SP8EBC/ParaCNTRL/README.md

# ParaCNTRL
FM repeater controller build w/o using any microntroller, Arduino or even Raspberry PI ;) Only op-amps and 74HCxx inside ;)
