SP8EBC/ParaCNTRL/_output_files/hw-rev-a/micros_com_pl.odt

## Your order

Item | | Name | Quantity | Net price | Net value
1 | (https://www.micros.com.pl/gfx/micros/_thumbsms/mediaserver/ac/65/82/ac6582d0db987ab54aea2be8b7d9221c,mFPcf2SPaw.jpg) (https://www.micros.com.pl/gfx/micros/_thumbsms/mediaserver/ac/65/82/ac6582d0db987ab54aea2be8b7d9221c,mFPcf2SPaw.jpg) | 74LVC1G06GW,125 Nexperia (https://www.micros.com.pl/en/product/ut006lvc1g-gw,126243.html)Micros part number: UT006lvc1g gw Manufacturer: NXP Manufacturer part number: 74LVC1G06GW RoHS Case style: SC70-5 t/r 5 0,8100 PLN 4,05 PLN Total:: 5 4,05 PLN
2 | (https://www.micros.com.pl/gfx/micros/_thumbsms/mediaserver/cb/0e/c9/cb0ec908718b7982ce16db11b44bc81b,mFPcf2SPaw.jpg) (https://www.micros.com.pl/gfx/micros/_thumbsms/mediaserver/cb/0e/c9/cb0ec908718b7982ce16db11b44bc81b,mFPcf2SPaw.jpg) | 74LVC1G06 SOT23-5 (https://www.micros.com.pl/en/product/ut006lvc1g-dbv,51417.html)Micros part number: UT006lvc1g dbv Manufacturer: Texas Instruments Manufacturer part number: SN74LVC1G06DBVR RoHS Case style: SOT23-5/t/r 5 1,0500 PLN 5,25 PLN Total:: 5 5,25 PLN
3 | (https://www.micros.com.pl/gfx/micros/_thumbsms/mediaserver/19/ed/58/19ed5894784a9232bdaf99e90b2cf70d,mFPcf2SPaw.jpg) (https://www.micros.com.pl/gfx/micros/_thumbsms/mediaserver/19/ed/58/19ed5894784a9232bdaf99e90b2cf70d,mFPcf2SPaw.jpg) | TAJB106K020RNJ AVX/ 293D106X9020B2TE3 VISHAY Capacitor (https://www.micros.com.pl/en/product/ktsb-10-0020k,17437.html)Micros part number: KTSB 10.00/20k Manufacturer: AVX Manufacturer part number: TAJB106K020RNJ RoHS Case style: smdB 3 1,6300 PLN 4,89 PLN Total:: 3 4,89 PLN
4 | (https://www.micros.com.pl/gfx/micros/_thumbsms/mediaserver/19/ed/58/19ed5894784a9232bdaf99e90b2cf70d,mFPcf2SPaw.jpg) (https://www.micros.com.pl/gfx/micros/_thumbsms/mediaserver/19/ed/58/19ed5894784a9232bdaf99e90b2cf70d,mFPcf2SPaw.jpg) | TAJB226K020RNJ AVX/ 293D226X9020B2TE3 VISHAY Capacitor (https://www.micros.com.pl/en/product/ktsb-22-0020k,67834.html)Micros part number: KTSB 22.00/20k Manufacturer: AVX Manufacturer part number: TAJB226K020RNJ RoHS Case style: smdB 6 1,3200 PLN 7,92 PLN Total:: 6 7,92 PLN

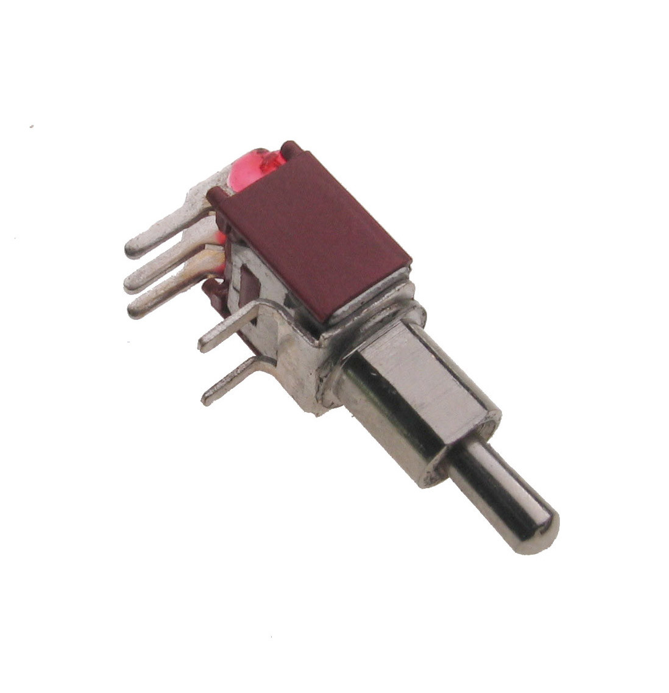
[picture p1: figure]
PRZ Smts103-2c3

5 | (https://www.micros.com.pl/gfx/micros/_thumbsms/mediaserver/ca/92/e7/ca92e7755cf07c80c8746512d54e2226,mFPcf2SPaw.jpg) (https://www.micros.com.pl/gfx/micros/_thumbsms/mediaserver/ca/92/e7/ca92e7755cf07c80c8746512d54e2226,mFPcf2SPaw.jpg) | SMTS103-2C3; toggle switch; (https://www.micros.com.pl/en/product/prz-smts103-2c3,19807.html)Micros part number: PRZ Smts103-2c3 Manufacturer: SWI Manufacturer part number: SMTS103-2C3 RoHS Case style: Rys.SMTS103-2C3 3 3,4300 PLN 10,29 PLN Total:: 3 10,29 PLN
6 | (https://www.micros.com.pl/gfx/micros/_thumbsms/mediaserver/99/41/b0/9941b08c1a6434a5edda34bfec541344,mFPcf2SPaw.jpg) (https://www.micros.com.pl/gfx/micros/_thumbsms/mediaserver/99/41/b0/9941b08c1a6434a5edda34bfec541344,mFPcf2SPaw.jpg) | SMTS202-2C3; toggle switch; (https://www.micros.com.pl/en/product/prz-smts202-2c3,19808.html)Micros part number: PRZ Smts202-2c3 Manufacturer: SWI Manufacturer part number: SMTS202-2C3 RoHS Case style: Rys.SMTS202-2C3 2 3,9300 PLN 7,86 PLN Total:: 2 7,86 PLN
7 | (https://www.micros.com.pl/gfx/micros/_thumbsms/mediaserver/3e/b4/0f/3eb40f9707c2ff876c856c0472e9234c,mFPcf2SPaw.jpg) (https://www.micros.com.pl/gfx/micros/_thumbsms/mediaserver/3e/b4/0f/3eb40f9707c2ff876c856c0472e9234c,mFPcf2SPaw.jpg) | SOP04E SAB dip-switch IC type, 4 contacts, SMD montage p. 1.27mm (https://www.micros.com.pl/en/product/prz-dipicns04,37205.html)Micros part number: PRZ DipICns04 Manufacturer: SAB Manufacturer part number: SOP04E RoHS Case style: Rys.dswICns4 1 5,6600 PLN 5,66 PLN Total:: 1 5,66 PLN
8 | (https://www.micros.com.pl/gfx/micros/_thumbsms/mediaserver/94/1f/1e/941f1e0265697d530bcd1b340b5c7ba9,mFPcf2SPaw.jpg) (https://www.micros.com.pl/gfx/micros/_thumbsms/mediaserver/94/1f/1e/941f1e0265697d530bcd1b340b5c7ba9,mFPcf2SPaw.jpg) | Single turn shaft potentiometer; 10K (https://www.micros.com.pl/en/product/po-r16148-1a-2-a10k,114040.html)Micros part number: PO R16148-1A-2-A10K Manufacturer: BOCHEN Manufacturer part number: WH148-1A-2-A 10kR RoHS Case style: Rys.R16148-1A-2 5 1,5400 PLN 7,70 PLN Total:: 5 7,70 PLN

Net products | Net delivery cost | Net amount | VAT 23 % | Total cost
53,62 PLN | 24,02 PLN | 77,64 PLN | 17,86 PLN | 95,50 PLN
