SP8EBC/ParaCNTRL/_output_files/Screenshot 2023-04-19 at 16-11-43 Order _ Micros.png

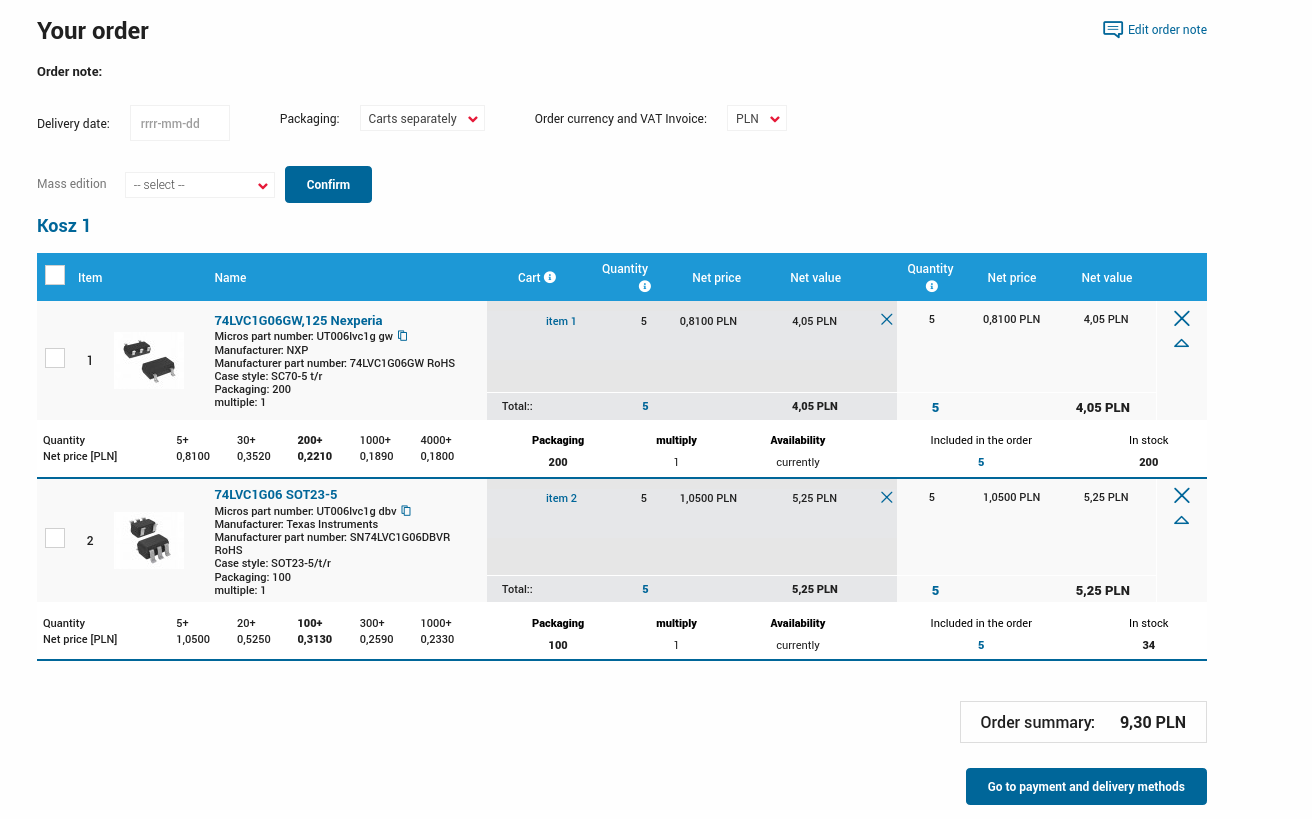
_output_files/Screenshot 2023-04-19 at 16-11-43 Order _ Micros.png
