SP8EBC/ParaCNTRL/74HC244D_652/74HC244D_652.step

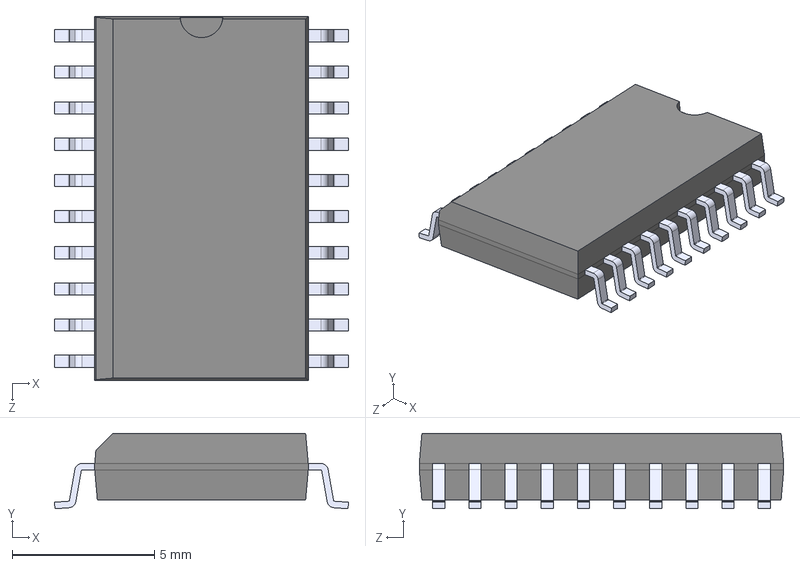
[picture p3: CAD file, 2023-02-25]
74HC244D_652/74HC244D_652.step
10.3 x 2.65 x 12.8 mm
