SP8EBC/ParaCNTRL/NFE31PT222Z1E9L/NFE31PT222Z1E9L.step

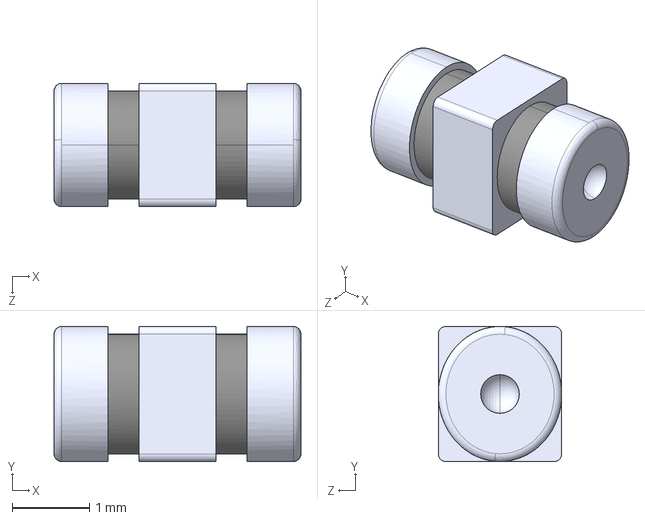
[picture p4: CAD file, 2023-02-25]
NFE31PT222Z1E9L/NFE31PT222Z1E9L.step
3.20 x 1.75 x 1.60 mm
