SP8EBC/ParaCNTRL/PLT10HH1026R0PNL/PLT10HH1026R0PNL.step

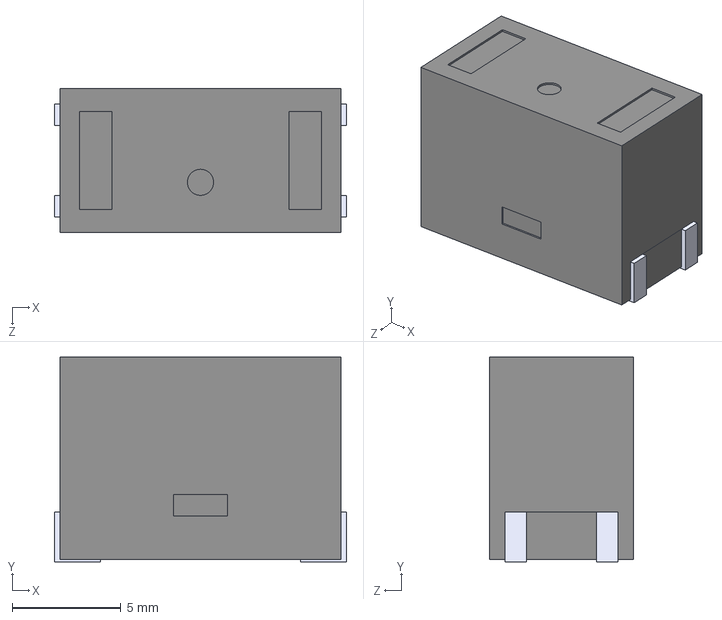
[picture p5: CAD file, 2023-02-25]
PLT10HH1026R0PNL/PLT10HH1026R0PNL.step
13.4 x 9.40 x 6.60 mm
