SP8EBC/ParaCNTRL/(threads)

Thread 1 (2023-06-17):

Problems with hardware revision B

SP8EBC, 2023-06-17:
1. IC702 doesn't have supply voltage and ground connected
2. Unconnected ground plane around C503, influences U20
3. Missing buffering of ROGER_PTT_CNTRL_OUT signal. Workarounded by reducing R208
4. Some potentiometers are flipped that decreasing signal goes clockwise, which is weird and uncommon.
