SP8EBC/ParaCNTRL/_output_files/hw-rev-b/fm-rpt-control.pdf

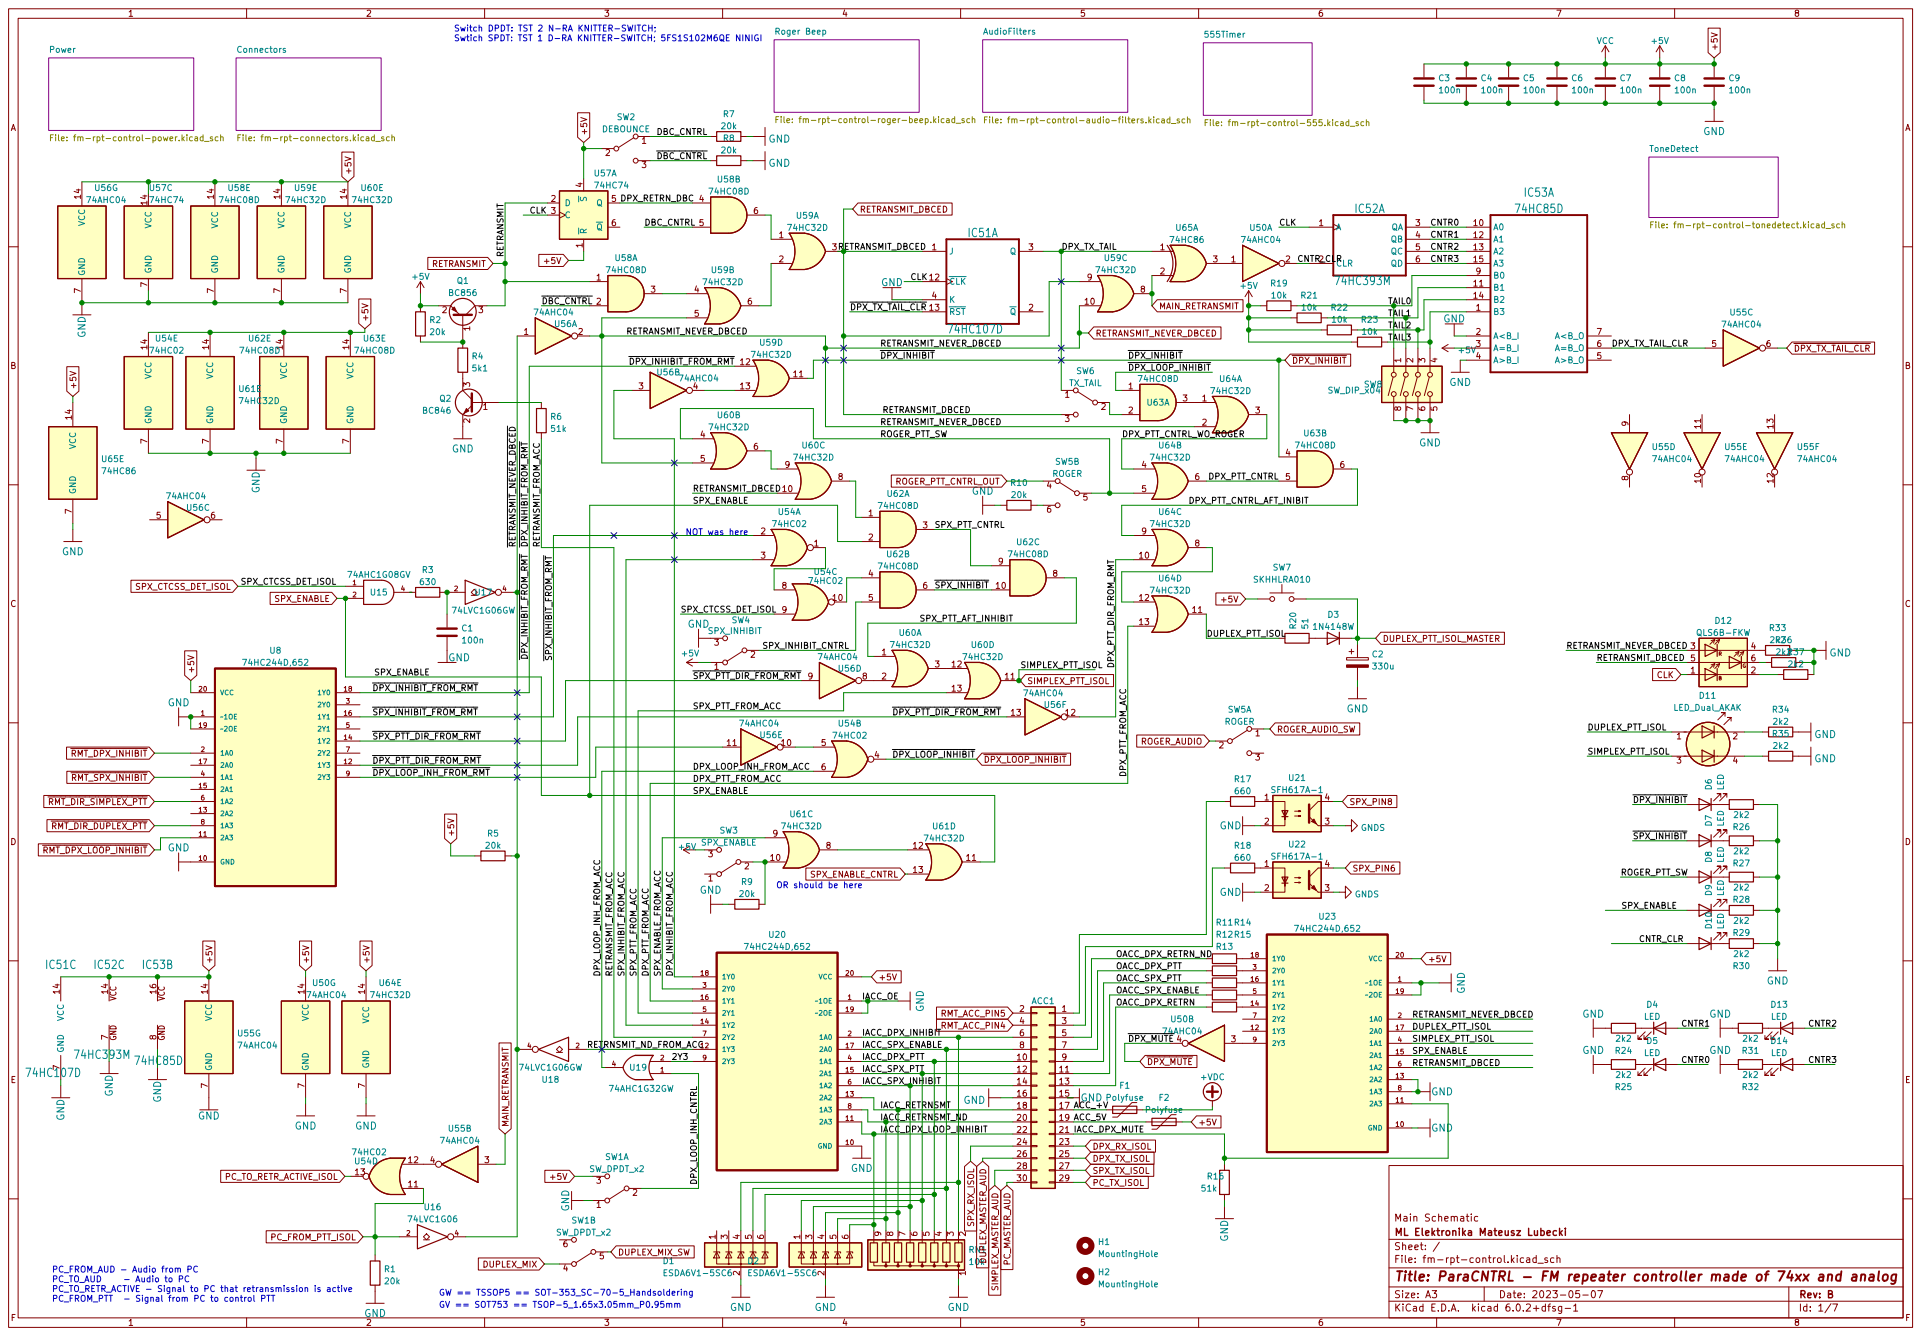
[picture p6: page 1]

Switch DPDT: TST 2 N-RA KNITTER-SWITCH; Swtich SPDT: TST 1 D-RA KNITTER-SWITCH; 5FS1S102M6QE NINIGI

555Timer File: fm-rpt-control-555.kicad_sch AudioFilters File: fm-rpt-control-audio-filters.kicad_sch

File: fm-rpt-control-roger-beep.kicad_sch Power File: fm-rpt-control-power.kicad_sch

File: fm-rpt-control.kicad_sch Sheet: / ML Elektronika Mateusz Lubecki Main Schematic

PC_FROM_AUD - Audio from PC
PC_TO_AUD - Audio to PC
PC_TO_RETR_ACTIVE - Signal to PC that retransmission is active
PC_FROM_PTT - Signal from PC to control PTT

Id: 1/7 Title: ParaCNTRL - FM repeater controller made of 74xx and analog

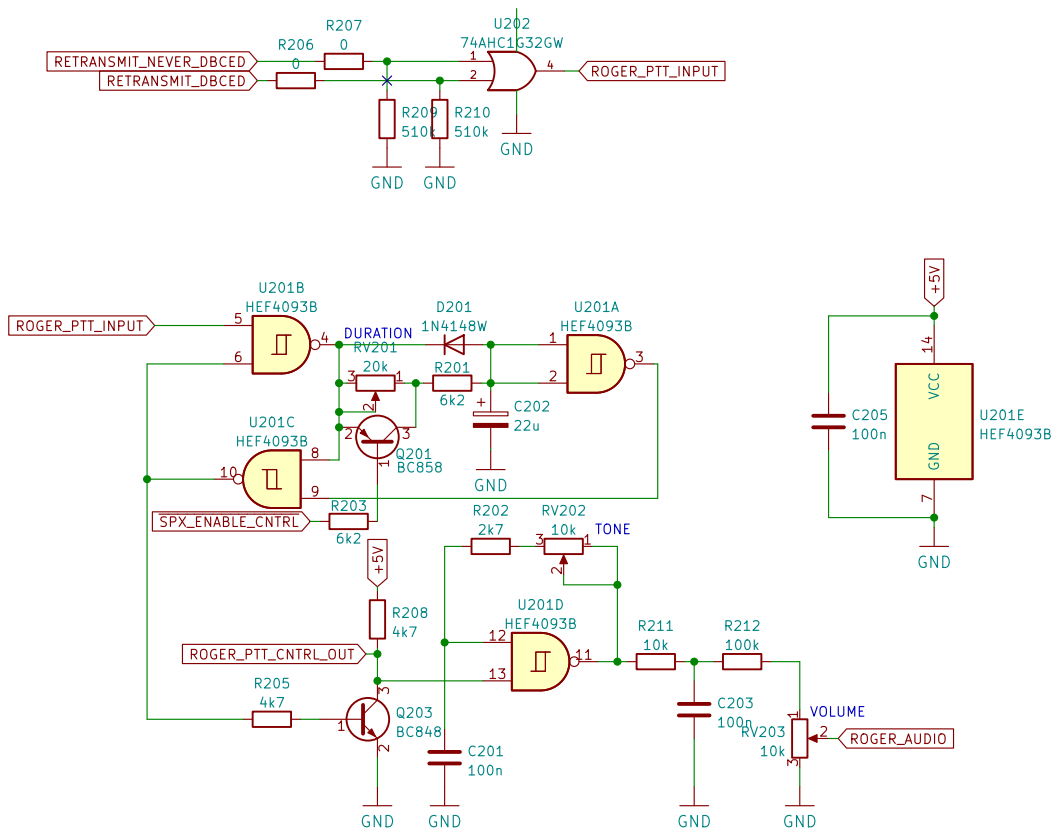
[picture p7: page 2]

Sheet: /Roger Beep/ ML Elektronika Mateusz Lubecki Roger Beep generator

File: fm-rpt-control-roger-beep.kicad_sch
Id: 2/7 Title: ParaCNTRL - FM repeater controller made of 74xx and analog

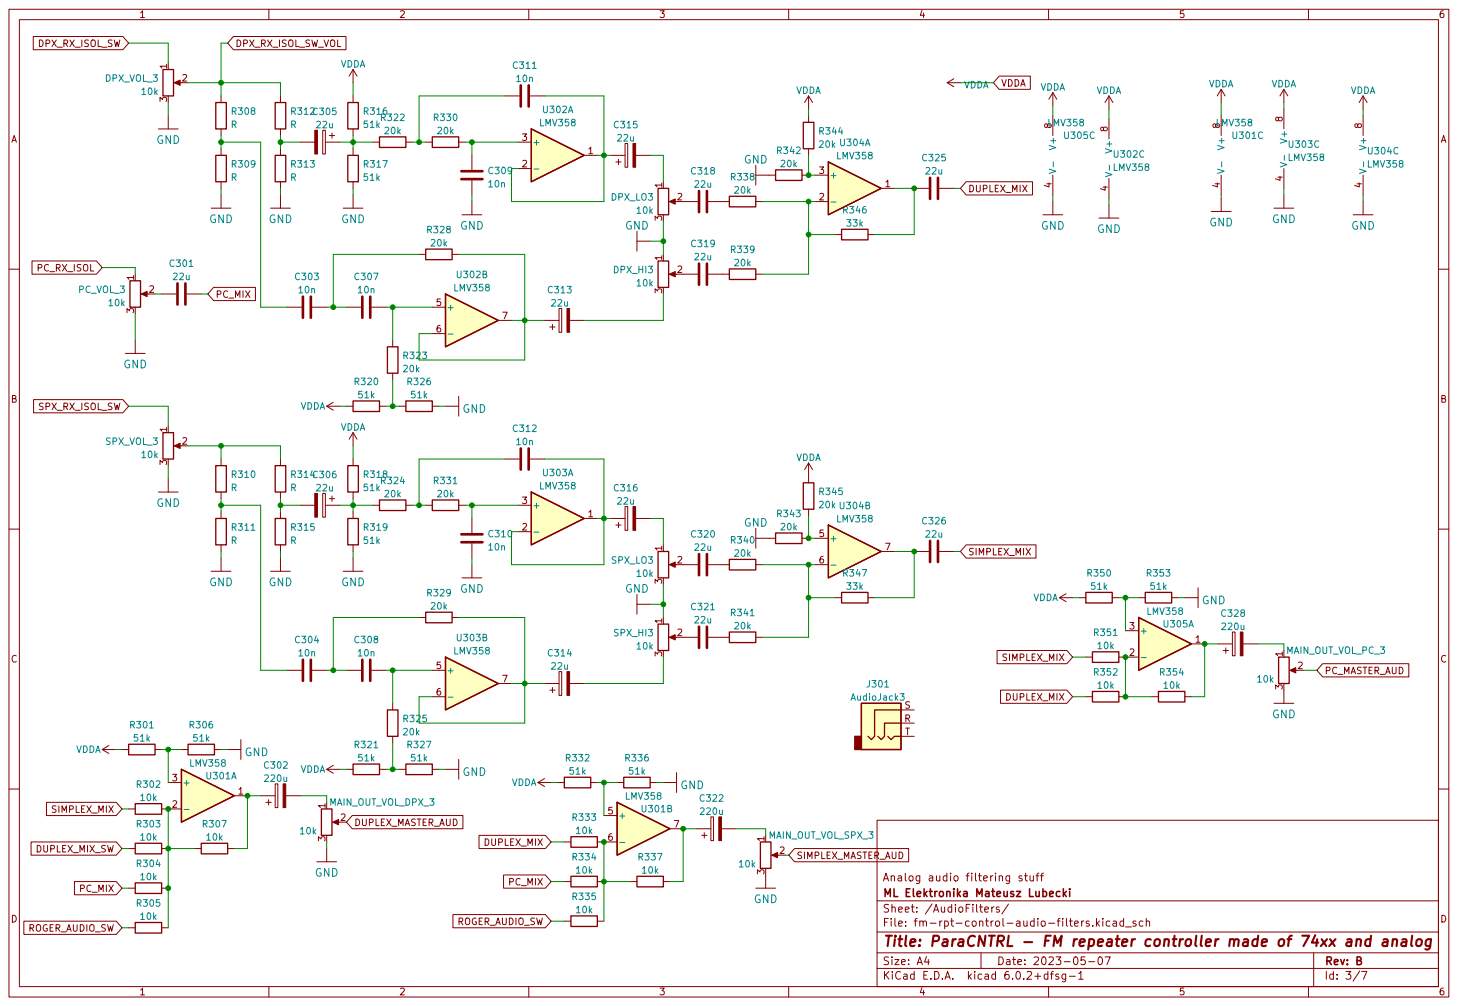
[picture p8: page 3]

Id: 3/7 Title: ParaCNTRL - FM repeater controller made of 74xx and analog

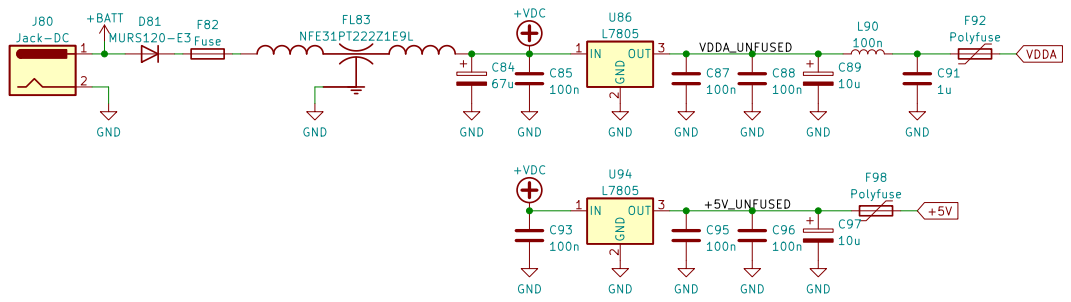
[picture p9: page 4]

File: fm-rpt-control-power.kicad_sch Sheet: /Power/ ML Elektronika Mateusz Lubecki Power supply

Id: 4/7 Title: ParaCNTRL - FM repeater controller made of 74xx and analog

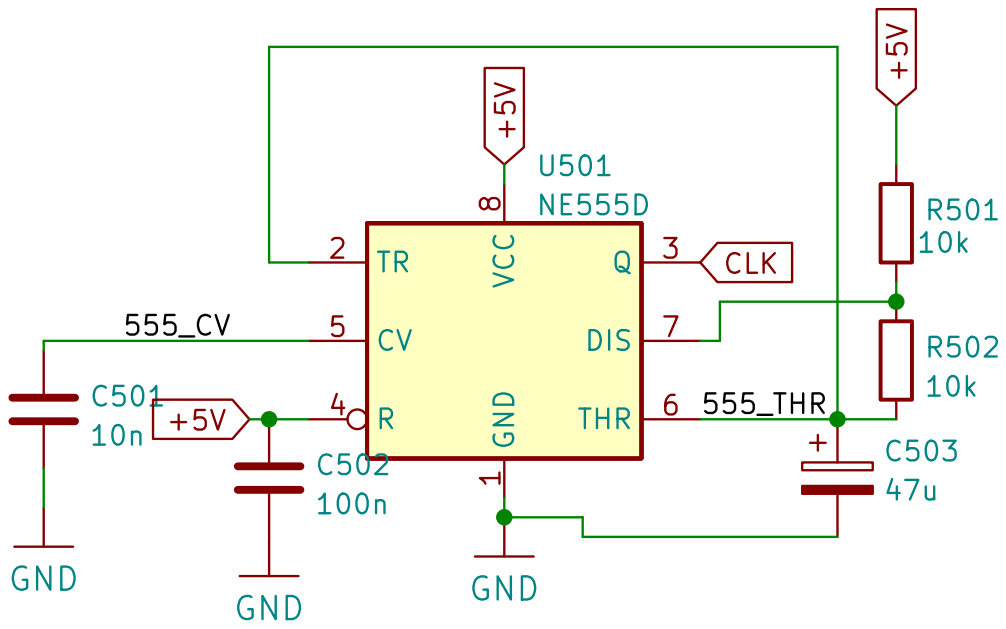
[picture p10: page 5]

File: fm-rpt-control-555.kicad_sch Sheet: /555Timer/ ML Elektronika Mateusz Lubecki GND

Id: 5/7 Title: ParaCNTRL - FM repeater controller made of 74xx and analog

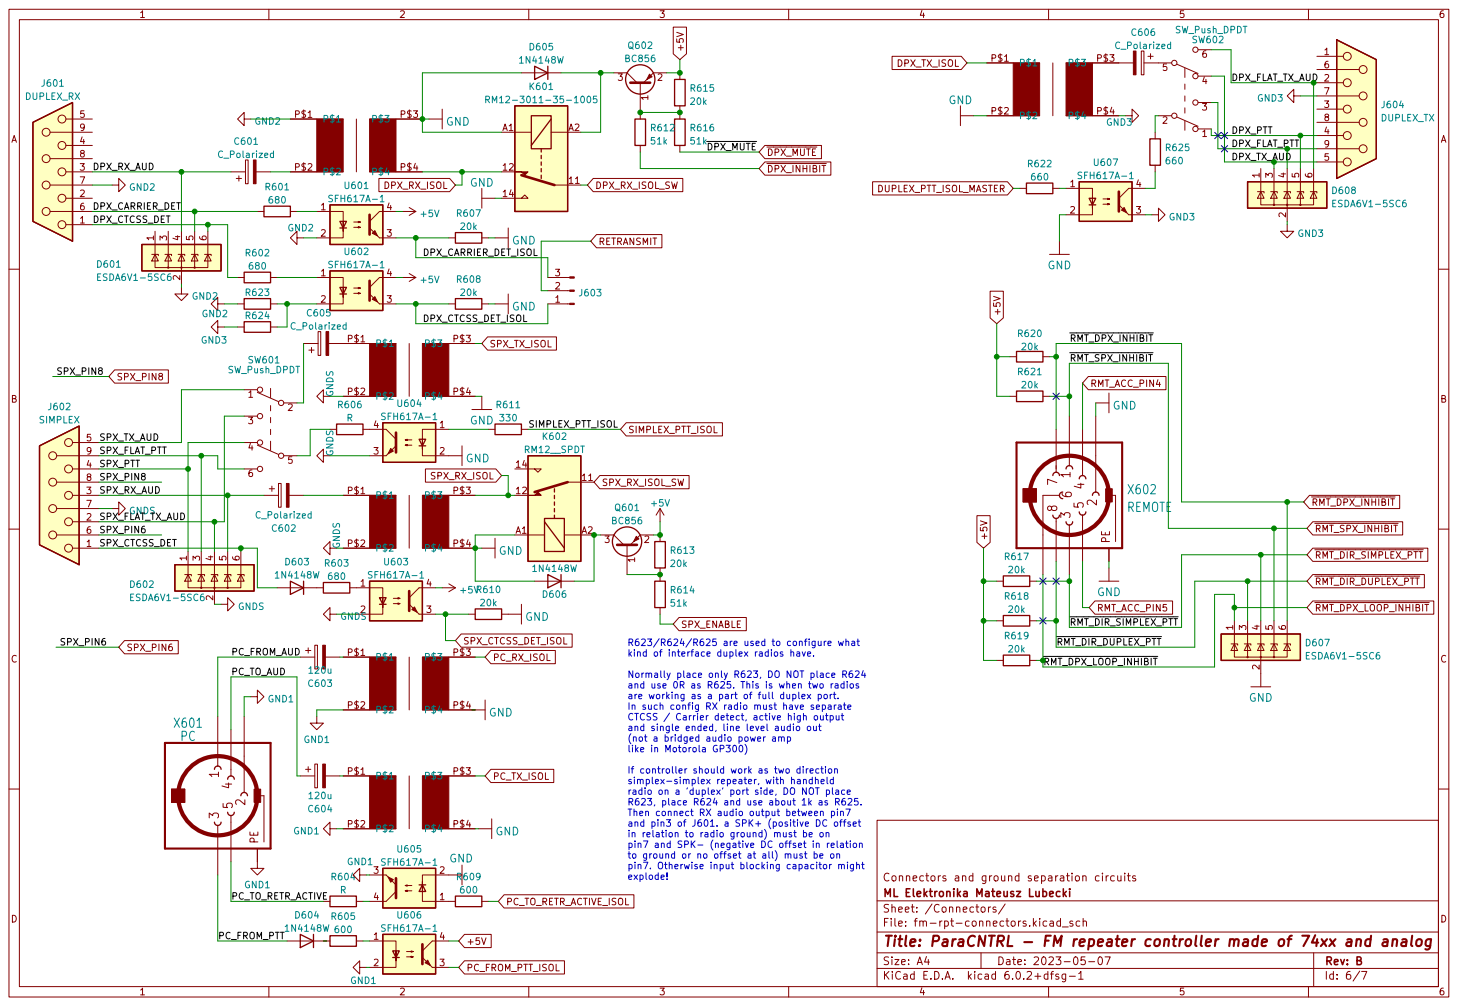
[picture p11: page 6]

R623/R624/R625 are used to configure what
kind of interface duplex radios have.

Normally place only R623, DO NOT place R624
and use 0R as R625. This is when two radios are working as a part of full duplex port.

In such config RX radio must have separate
CTCSS / Carrier detect, active high output
and single ended, line level audio out
(not a bridged audio power amp
like in Motorola GP300)

If controller should work as two direction
simplex-simplex repeater, with handheld
radio on a 'duplex' port side, DO NOT place
R623, place R624 and use about 1k as R625.
Then connect RX audio output between pin7
and pin3 of J601. a SPK+ (positive DC offset
in relation to radio ground) must be on
pin7 and SPK- (negative DC offset in relation
to ground or no offset at all) must be on
pin7. Otherwise input blocking capacitor might
explode!

File: fm-rpt-connectors.kicad_sch Sheet: /Connectors/ ML Elektronika Mateusz Lubecki Connectors and ground separation circuits

Id: 6/7 Title: ParaCNTRL - FM repeater controller made of 74xx and analog

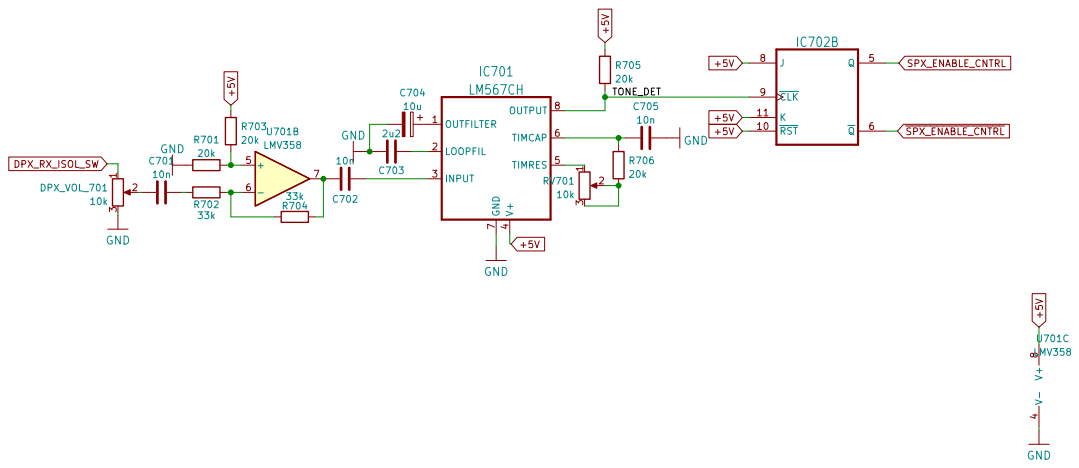
[picture p12: page 7]

File: fm-rpt-control-tonedetect.kicad_sch Sheet: /ToneDetect/ ML Elektronika Mateusz Lubecki Simplex enable remote control 1750Hz / 2600Hz tone detector

Id: 7/7 Title: ParaCNTRL - FM repeater controller made of 74xx and analog
