SP8EBC/ParaCNTRL/fm-rpt-control.kicad_pcb

## KiCad design fm-rpt-control.kicad_pcb (continued)

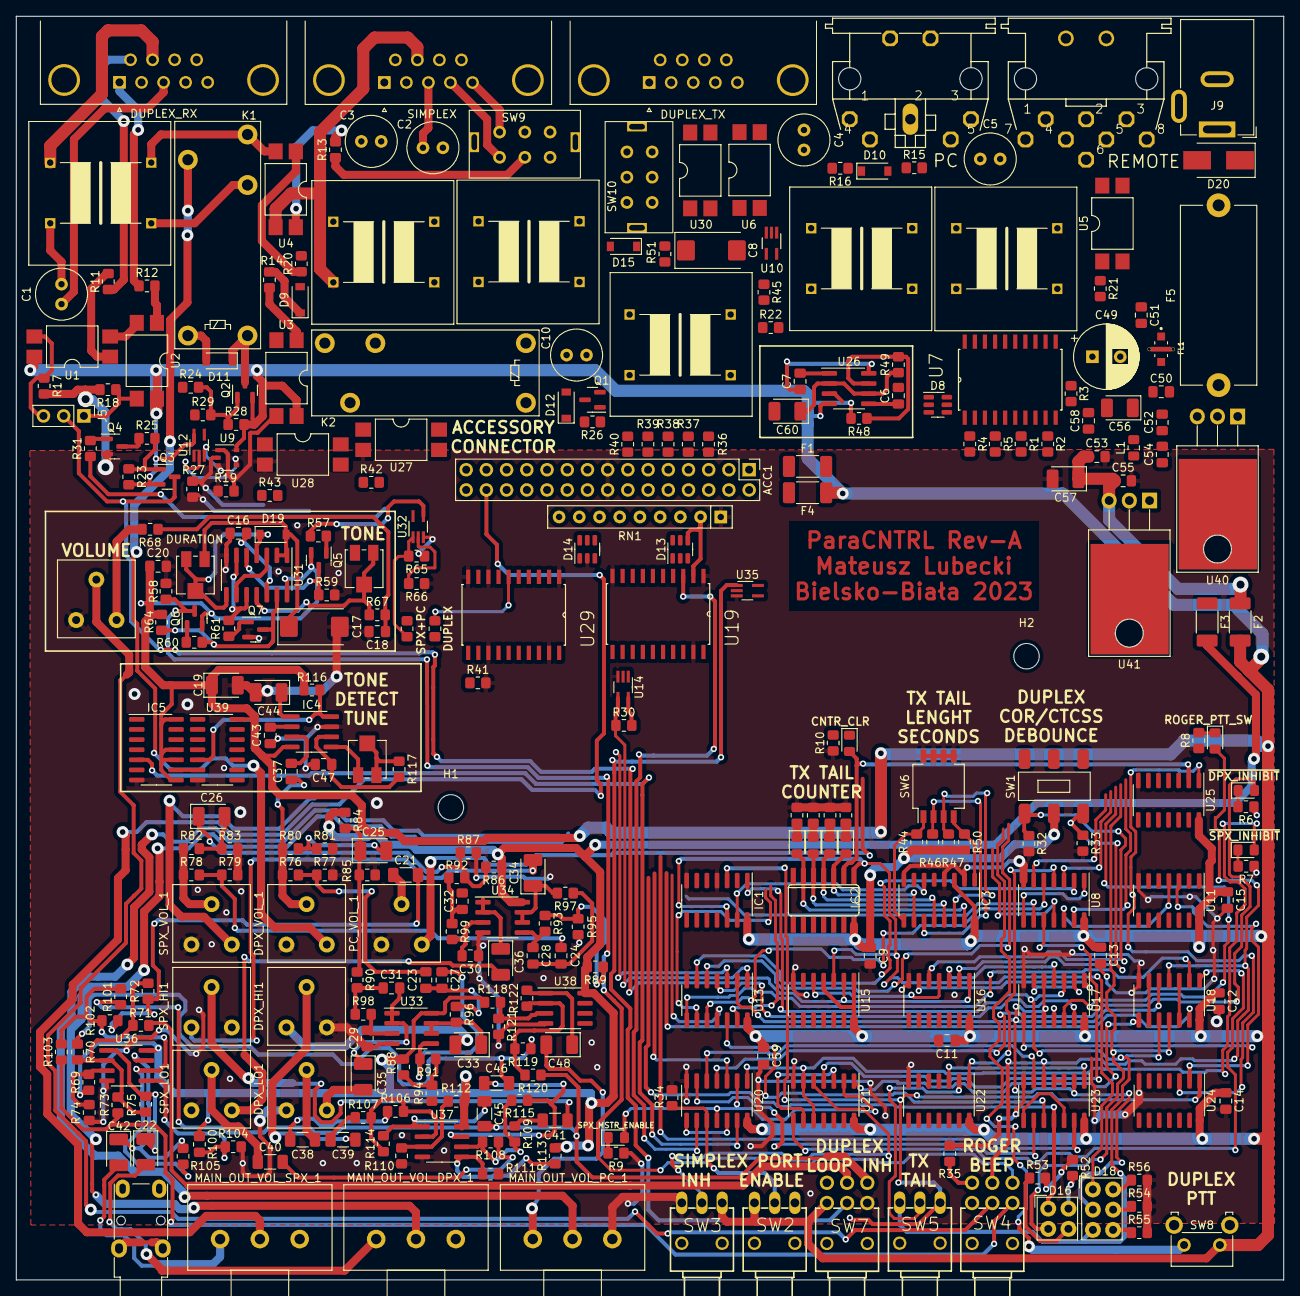
[picture p24: board fm-rpt-control.kicad_pcb from above]

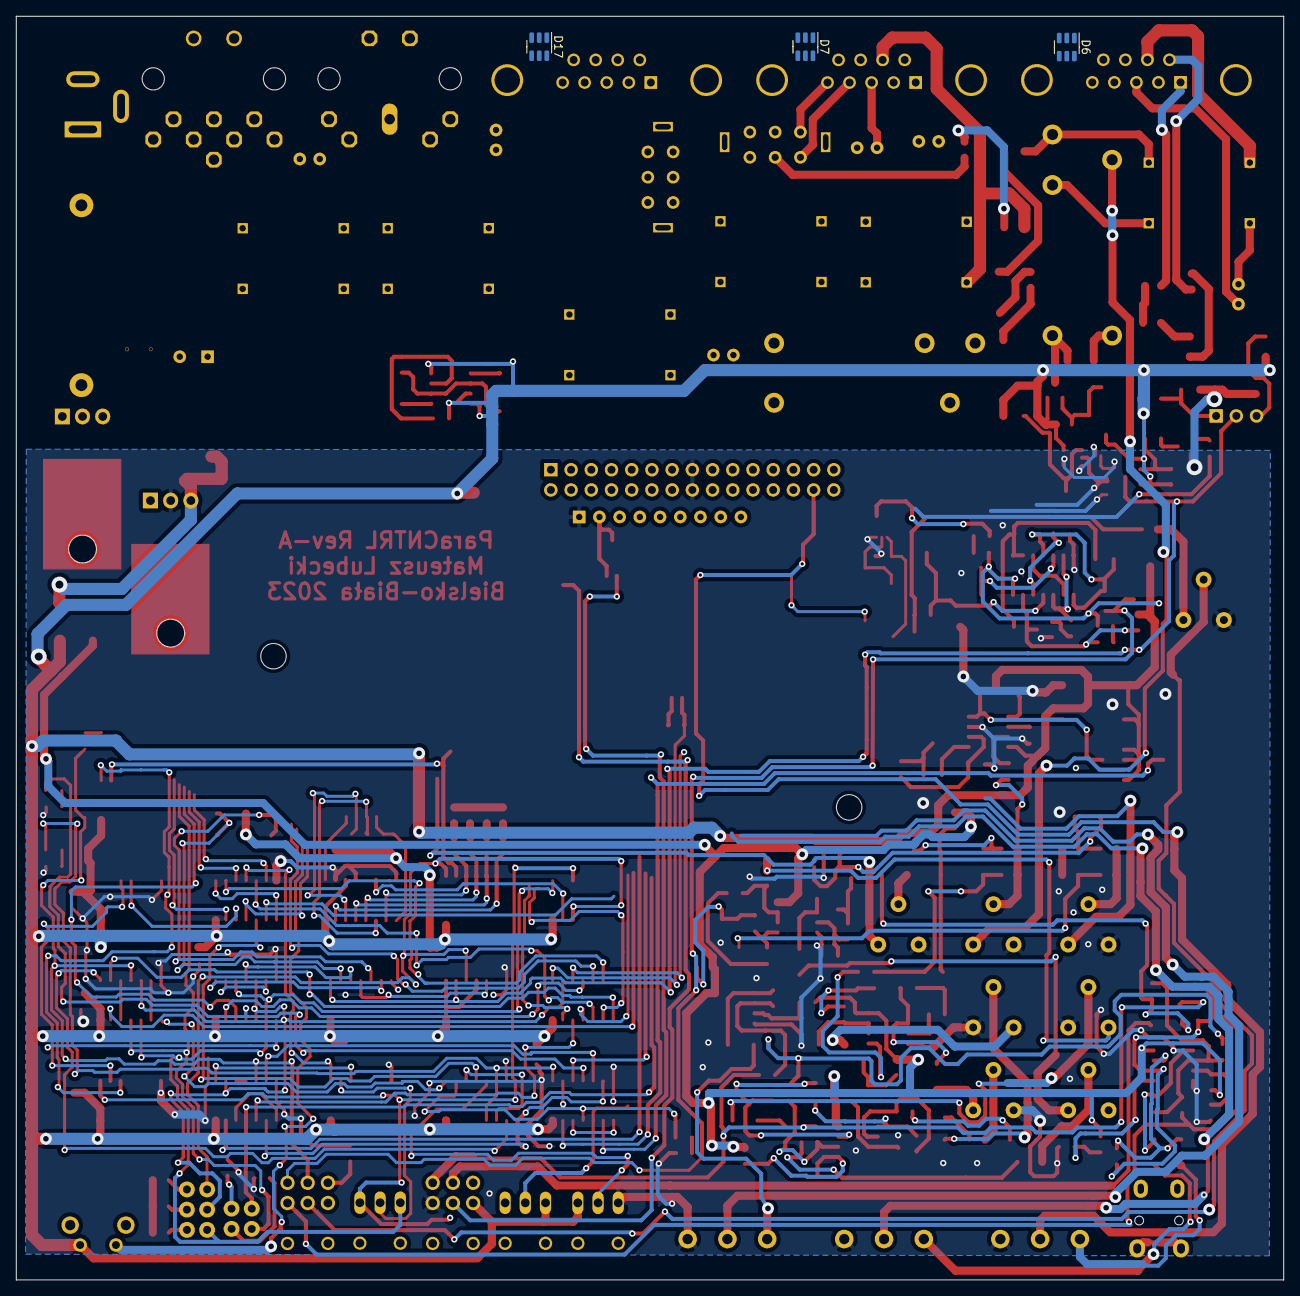
[picture p25: board fm-rpt-control.kicad_pcb from below]

Board: 2 copper layers, 159.3 x 158.8 mm, 314 parts (3 on the bottom side), 286 nets.
