SP8EBC/ParaCNTRL/(commit log)

2023-02-25 first commit with kicad files
    [74HC244D_652.step, NFE31PT222Z1E9L.step, PLT10HH1026R0PNL.step, fm-rpt-control-audio-filters.kicad_sch, fm-rpt-control-roger-beep.kicad_sch, fm-rpt-control.kicad_pcb, fm-rpt-control.kicad_sch]
2023-02-26 second daily
    [fm-rpt-control-audio-filters.kicad_sch, fm-rpt-control-power.kicad_sch, fm-rpt-control-roger-beep.kicad_sch, fm-rpt-control.kicad_sch]
2023-03-08 schematic design ready
    [fm-rpt-control-audio-filters.kicad_sch, fm-rpt-control-power.kicad_sch, fm-rpt-control-roger-beep.kicad_sch, fm-rpt-control.kicad_sch]
2023-03-09 PCB dimenstions set and db/din sockets, pots, switches and leds placed
    [fm-rpt-control-audio-filters.kicad_sch, fm-rpt-control-power.kicad_sch, fm-rpt-control-roger-beep.kicad_sch, fm-rpt-control.kicad_pcb, fm-rpt-control.kicad_sch]
2023-03-09 controlling to_pc_retransmission line
    [fm-rpt-control-audio-filters.kicad_sch, fm-rpt-control-power.kicad_sch, fm-rpt-control-roger-beep.kicad_sch, fm-rpt-control.kicad_pcb, fm-rpt-control.kicad_sch]
2023-03-12 logic ics, relays and relay driving electronics, voltage regulators placed
    [fm-rpt-control-audio-filters.kicad_sch, fm-rpt-control-power.kicad_sch, fm-rpt-control-roger-beep.kicad_sch, fm-rpt-control.kicad_pcb, fm-rpt-control.kicad_sch]
2023-03-13 before replacing some pinheaders with switches
    [fm-rpt-control-audio-filters.kicad_sch, fm-rpt-control-roger-beep.kicad_sch, fm-rpt-control.kicad_pcb, fm-rpt-control.kicad_sch]
2023-03-13 +5v bus removed completely
    [fm-rpt-control-audio-filters.kicad_sch, fm-rpt-control-power.kicad_sch, fm-rpt-control-roger-beep.kicad_sch, fm-rpt-control.kicad_sch]
2023-03-13 short fixed
    [fm-rpt-control-audio-filters.kicad_sch, fm-rpt-control-power.kicad_sch, fm-rpt-control-roger-beep.kicad_sch, fm-rpt-control.kicad_pcb, fm-rpt-control.kicad_sch]
2023-03-14 all components placed on pcb
    [fm-rpt-control-555.kicad_sch, fm-rpt-control-audio-filters.kicad_sch, fm-rpt-control.kicad_pcb, fm-rpt-control.kicad_sch]
2023-03-15 some traces in logic section
    [fm-rpt-control.kicad_pcb, fm-rpt-control.kicad_sch]
2023-03-28 before moving connector to separate schematic scheets
2023-03-28 before moving separated connectors to distinct scheet
    [fm-rpt-control.kicad_sch]
2023-03-28 pcb synced with schematics
    [fm-rpt-control.kicad_sch]
2023-03-28 moved to separate scheed, before reasigning designators
    [fm-rpt-connectors.kicad_sch, fm-rpt-control.kicad_sch]
2023-03-28 connector annotated
    pcb updated after manually annotating back connector sheet
    all scheets reanotated in new way
    all scheets reanotated in new way ...
    [fm-rpt-connectors.kicad_sch, fm-rpt-control-555.kicad_sch, fm-rpt-control-audio-filters.kicad_sch, fm-rpt-control-roger-beep.kicad_sch, fm-rpt-control.kicad_sch]
2023-04-03 gerber files, some minor bugs in PCB solved
    [fm-rpt-connectors.kicad_sch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]
2023-04-04 bugfix: not negating DPX_TX_TAIL_CLR before feeding 74hc107
    [fm-rpt-connectors.kicad_sch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]
2023-04-29 roger beep sligtly redesigned during assembly and debugging, bom with prices
    [fm-rpt-connectors.kicad_sch, fm-rpt-control-roger-beep.kicad_sch, fm-rpt-control.kicad_sch, fm-rpt-control_bill_of_material.xls, tme_para-cntrl_2023-04-19.csv]
2023-05-01 some minor changes in schematic only after protoype testing
    [fm-rpt-control.kicad_sch]
2023-05-04 pullup,pulldown resistors changed
    [fm-rpt-connectors.kicad_sch, fm-rpt-control.kicad_sch]
2023-05-05 changes in pcb design rerouted except chanes around roger beep genrator. new hw rev
    [fm-rpt-connectors.kicad_sch, fm-rpt-control-555.kicad_sch, fm-rpt-control-audio-filters.kicad_sch, fm-rpt-control-power.kicad_sch, fm-rpt-control-roger-beep.kicad_sch, fm-rpt-control.kicad_sch]
2023-05-06 roger beep generator pcb design reworked
    [fm-rpt-connectors.kicad_sch, fm-rpt-control-audio-filters.kicad_sch, fm-rpt-control-power.kicad_sch, fm-rpt-control-roger-beep.kicad_sch, fm-rpt-control.kicad_sch]
2023-05-07 footprint of led indicators, rc delay network btween u9 and u12
    [fm-rpt-control.kicad_sch]
2023-05-07 lm567 tone detect test results
    [fm-rpt-control-B_Cu.gbl, fm-rpt-control-B_Mask.gbs, fm-rpt-control-B_Silkscreen.gbo, fm-rpt-control-Edge_Cuts.gm1, fm-rpt-control-F_Cu.gtl, fm-rpt-control-F_Mask.gts, fm-rpt-control-F_Silkscreen.gto, fm-rpt-control-NPTH-drl_map.gbr]
2023-05-07 simplex enable bugifx, now not inhibiting
    [fm-rpt-control.kicad_sch]
2023-05-07 simplex remote control tone detector redesigned, gerber files for hw-rev b
    [fm-rpt-connectors.kicad_sch, fm-rpt-control-555.kicad_sch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]
2023-05-08 changing rogereep duration depends on simplex enable or not
    [fm-rpt-control-roger-beep.kicad_sch, fm-rpt-control-tonedetect.kicad_sch]
2023-05-08 regenerated HW-revB gerbers
    [fm-rpt-control-B_Cu.gbl, fm-rpt-control-B_Mask.gbs, fm-rpt-control-B_Silkscreen.gbo, fm-rpt-control-Edge_Cuts.gm1, fm-rpt-control-F_Cu.gtl, fm-rpt-control-F_Mask.gts, fm-rpt-control-F_Silkscreen.gto, fm-rpt-control-NPTH-drl_map.gbr]
2023-06-10 values of few resistors changed according to testing first unit of hw rev b
    [fm-rpt-control-audio-filters.kicad_sch, fm-rpt-control-roger-beep.kicad_sch, fm-rpt-control.kicad_sch]
2023-06-19 some changes after testing hw revision b
    [fm-rpt-connectors.kicad_sch, fm-rpt-control-555.kicad_sch, fm-rpt-control-audio-filters.kicad_sch, fm-rpt-control-power.kicad_sch, fm-rpt-control-roger-beep.kicad_sch, fm-rpt-control-tonedetect.kicad_sch, fm-rpt-control.kicad_sch, lm567_tunning.ods]
2024-03-26 before fixing problems with potentiometers orientation
    [fm-rpt-control-tonedetect.kicad_sch, fm-rpt-control.kicad_sch]
